Oskar-Schwarzkopf/usb-wattmeter-pcb/HARDWARE/PCB_第二版PCB_2025-05-23.pdf

# LED1 LED3

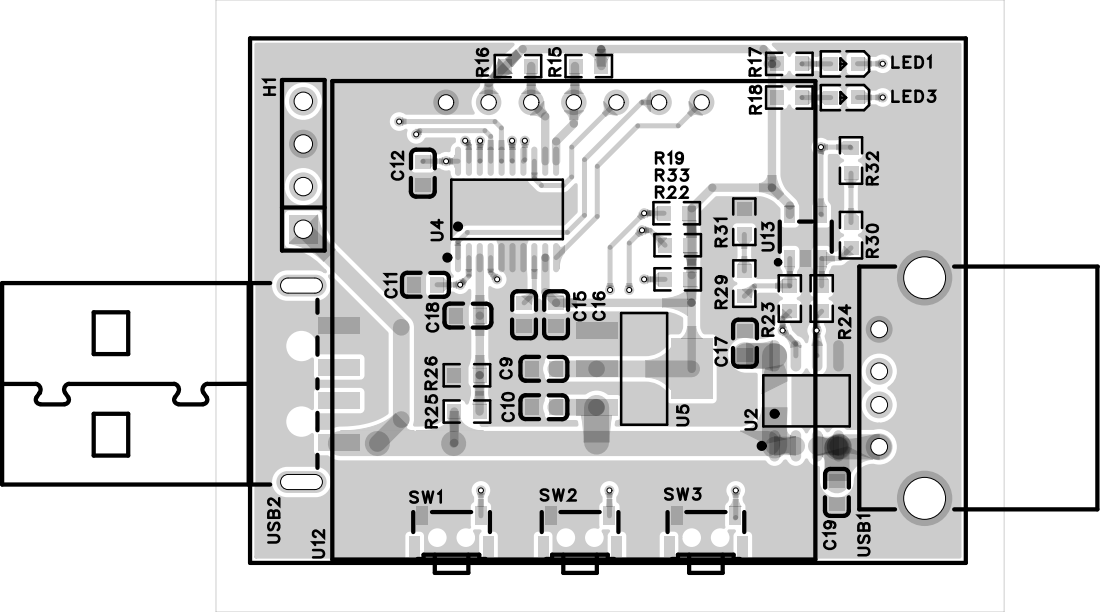
[picture p8: page 1]

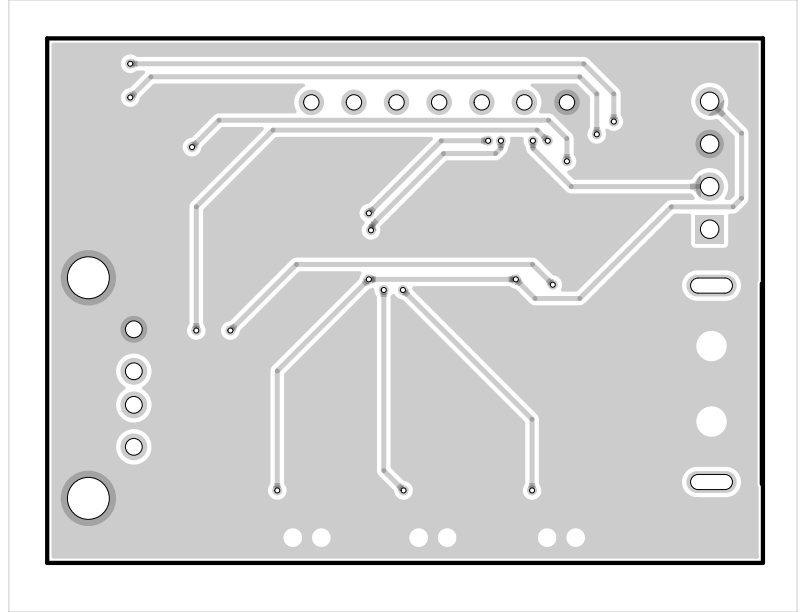
[picture p9: page 2]
