Oskar-Schwarzkopf/usb-wattmeter-pcb/HARDWARE/SCH_第二版原理图_1-P1_2025-05-23.pdf

# LED

## 显示电路

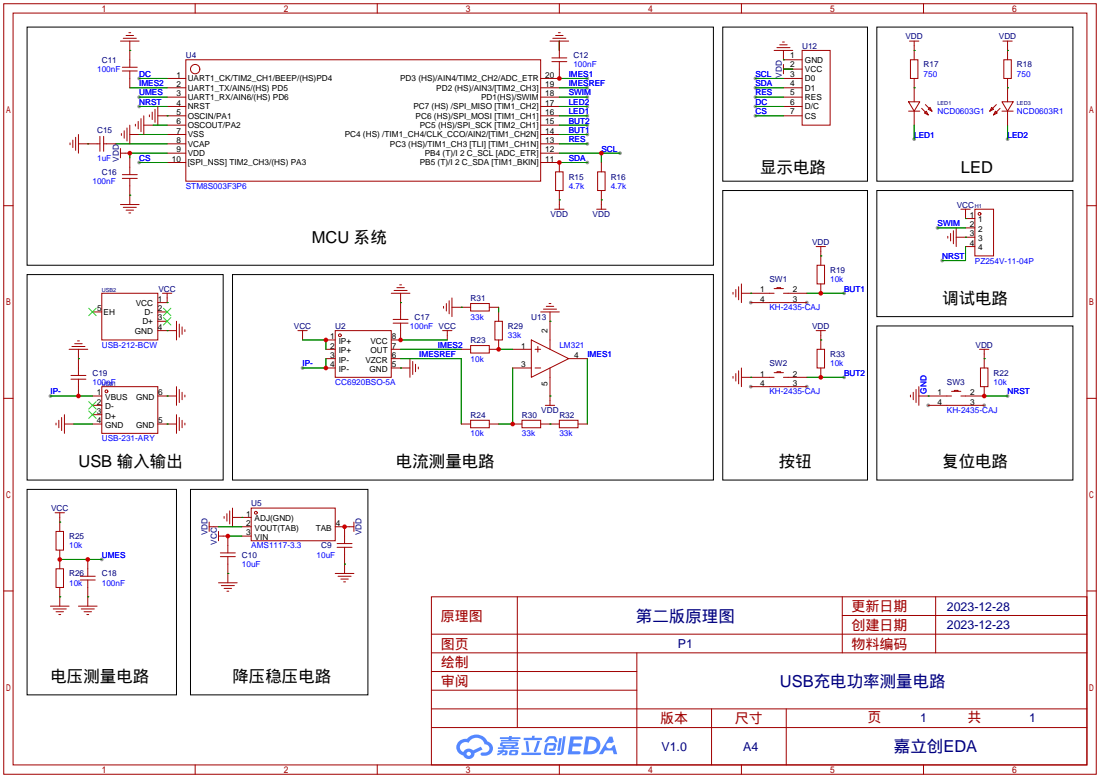
[picture p11: page 1]
