Oskar-Schwarzkopf/usb-wattmeter-pcb/HARDWARE/PCB_第一版PCB_2025-05-23.pdf

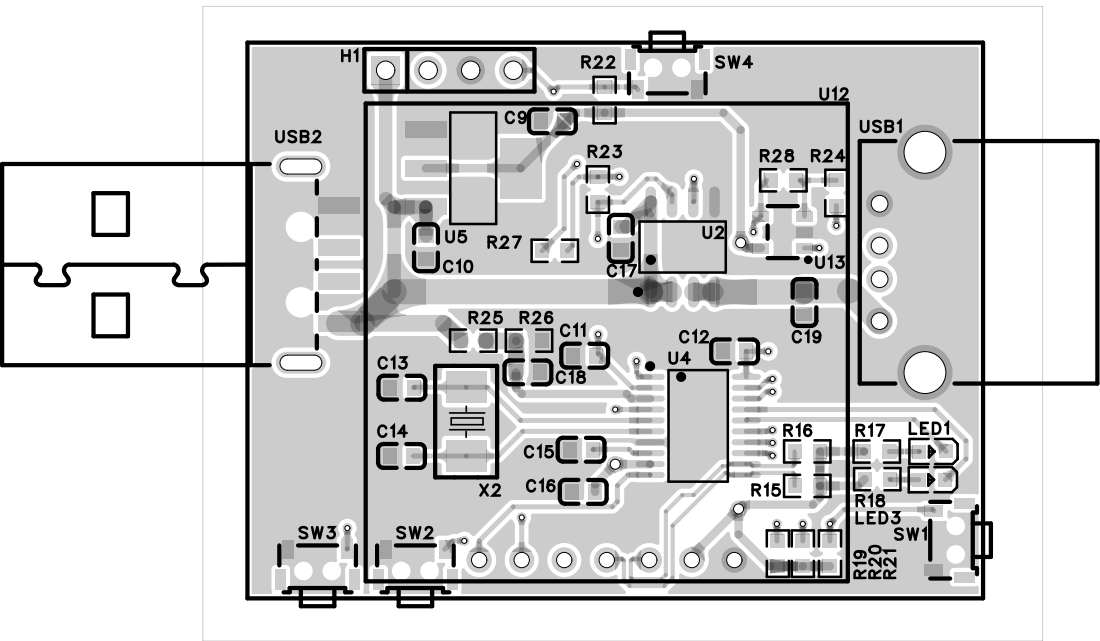
[picture p12: page 1]

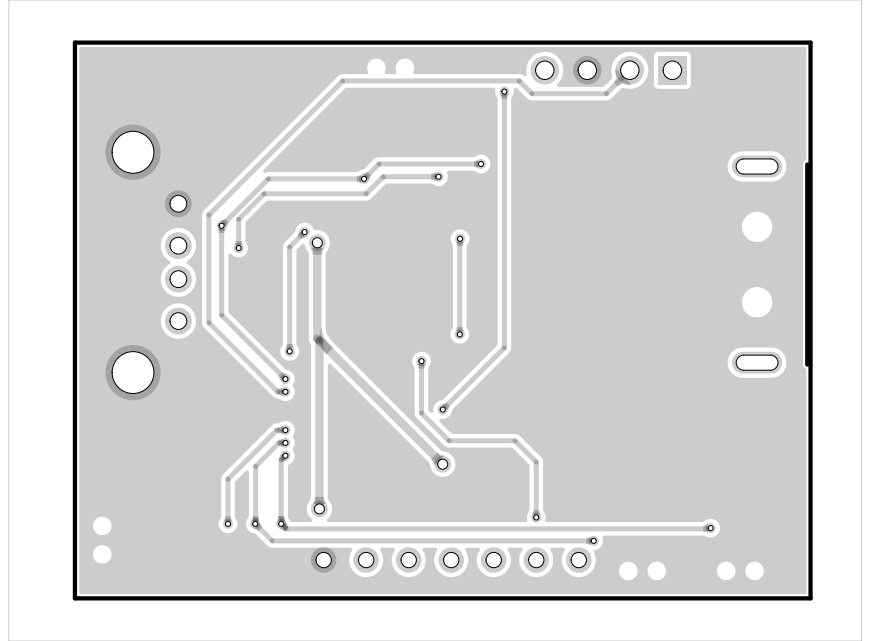
[picture p13: page 2]
