Oskar-Schwarzkopf/usb-wattmeter-pcb/USBPowerMetreGen2/App/disp.h

#ifndef __DISP_H
#define __DISP_H
void Disp_Digit_Mode();
void Disp_Power_Mode();
// void Disp_U_Mode();
// void Disp_I_Mode();
void Disp_init();
void Disp_Welcome();
// void Disp_Debug(char* Debug_str);
#endif
